Dmitry-Kondratyev/Audi80-TripComputer-ATmega8-Archive/(list of files, drawings)

Other design files:
Plata.pcb
